magyarm/beaglebone-fpga/HardwareDesignFiles/documentation/bonefpga.csv

ref | value | footprint | Field1 | Field2 | Field3 | Field4 | Field5 | Field6 | Field7 | Field8
C201 | 10UF | 0805 | JMK212BJ106KD-T
C202 | 0.1UF | 0603 | C1608X5R1E104K
C203 | 1NF | 0603 | C1608X7R1H102K
C204 | 10PF | 0603 | C1608C0G1H100D
C205 | 1NF | 0603 | C1608X7R1H102K
C206 | 10PF | 0603 | C1608C0G1H100D
C207 | 100PF | 0603 | C1608X7R1H101K
C208 | 100PF | 0603 | C1608X7R1H101K
C209 | 4.7UF | 0603 | JMK107BJ475KA-T
C210 | 4.7UF | 0603 | JMK107BJ475KA-T
C211 | 4.7UF | 0603 | JMK107BJ475KA-T
C212 | 4.7UF | 0603 | JMK107BJ475KA-T
C213 | 10UF | 0805 | JMK212BJ106KD-T
C214 | 0.1UF | 0603 | C1608X5R1E104K
C215 | 1NF | 0603 | C1608X7R1H102K
C216 | 10PF | 0603 | C1608C0G1H100D
C217 | 1NF | 0603 | C1608X7R1H102K
C218 | 100PF | 0603 | C1608X7R1H101K
C219 | 10PF | 0603 | C1608C0G1H100D
C220 | 100PF | 0603 | C1608X7R1H101K
C221 | 4.7UF | 0603 | JMK107BJ475KA-T
C222 | 4.7UF | 0603 | JMK107BJ475KA-T
C223 | 4.7UF | 0603 | JMK107BJ475KA-T
C224 | 4.7UF | 0603 | JMK107BJ475KA-T
C301 | 10UF | 0603 | JMK212BJ106KD-T
C302 | 0.1UF | 0603 | C1608X5R1E104K
C401 | 0.1UF | 0603 | C1608X5R1E104K
C402 | 0.1UF | 0603 | C1608X5R1E104K
C701 | 0.47UF | 0603 | C1608X5R1A474K
C702 | 0.47UF | 0603 | C1608X5R1A474K
C703 | 0.47UF | 0603 | C1608X5R1A474K
C704 | 0.47UF | 0603 | C1608X5R1A474K
C705 | 0.47UF | 0603 | C1608X5R1A474K
C706 | 0.47UF | 0603 | C1608X5R1A474K
C707 | 0.47UF | 0603 | C1608X5R1A474K
C708 | 0.47UF | 0603 | C1608X5R1A474K
C709 | 0.47UF | 0603 | C1608X5R1A474K
C710 | 0.47UF | 0603 | C1608X5R1A474K
C711 | 0.47UF | 0603 | C1608X5R1A474K
C712 | 0.47UF | 0603 | C1608X5R1A474K
C713 | 4.7UF | 0603 | JMK107BJ475KA-T
C714 | 4.7UF | 0603 | JMK107BJ475KA-T
C715 | 4.7UF | 0603 | JMK107BJ475KA-T
C716 | 4.7UF | 0603 | JMK107BJ475KA-T
C717 | 4.7UF | 0603 | JMK107BJ475KA-T
C718 | 4.7UF | 0603 | JMK107BJ475KA-T
C719 | 100UF | 1206 | JMK316BJ107ML-T
C720 | 100UF | 1206 | JMK316BJ107ML-T
C721 | 100UF | 1206 | JMK316BJ107ML-T
C722 | 100UF | 1206 | JMK316BJ107ML-T
C723 | 100UF | 1206 | JMK316BJ107ML-T
C724 | 100UF | 1206 | JMK316BJ107ML-T
C725 | 0.1UF
C726 | 0.1UF
C727 | 0.1UF
C728 | 0.1UF
C729 | 0.1UF
C730 | 0.1UF
C731 | 4.7UF
C732 | 4.7UF
C733 | 4.7UF
C734 | 4.7UF
C735 | 4.7UF
C736 | 4.7UF
C737 | 100UF
C738 | 100UF
C739 | 100UF
C740 | 100UF
C741 | 100UF
C742 | 100UF
J701 | 3_WAY_JUMPER | 3 Pins, 2.54mm spacing, 1.02 hole diameter | TSHC-103-S-06-240-G-LF
J702 | 3_WAY_JUMPER | 3 Pins, 2.54mm spacing, 1.02 hole diameter | TSHC-103-S-06-240-G-LF
L201 | 2.2UH | 5.7x4.7 | NR6028T2R2N
L202 | 2.2UH | 5.7x4.7 | NR6028T2R2N
L203 | 2.2UH | 5.7x4.7 | NR6028T2R2N
L204 | 2.2UH | 5.7x4.7 | NR6028T2R2N
Q201 | 2N7002K | SOT-23-3 (TO-236) | 2N7002K-T1-E3
R201 | 10K | 0603 | ERJ-3GEYJ103V
R202 | 10K | 0603 | ERJ-3GEYJ103V
R203 | 0OHM | 0603 | DNI | ERJ-3EKF6042V
R204 | 0OHM | 0603 | ERJ-3EKF6042V
R205 | 150K | 0603 | ERJ-3GEYJ103V
R206 | 13K | 0603 | ERJ-3EKF1302V
R207 | 13K | 0603 | ERJ-3EKF1302V
R208 | 30K | 0603 | ERJ-3EKF3002V
R209 | 30K | 0603 | ERJ-3EKF3002V
R210 | 95.3K | 0603 | ERJ-3EKF9532V
R211 | 30K | 0603 | ERJ-3EKF3002V
R212 | 10K | 0603 | ERJ-3GEYJ103V
R213 | 10K | 0603 | ERJ-3GEYJ103V
R214 | 0OHM | 0603 | ERJ-3EKF6042V
R215 | 0OHM | 0603 | ERJ-3EKF6042V
R216 | 150K | 0603 | ERJ-3GEYJ103V
R217 | 95.3K | 0603 | ERJ-3EKF9532V
R218 | 13K | 0603 | ERJ-3EKF1302V
R219 | 100_OHM | 0603 | ERJ-3EKF1100V
R220 | 13K | 0603 | ERJ-3EKF1302V
R221 | 60_4K | 0603 | ERJ-3EKF6042V
R222 | 30K | 0603 | ERJ-3EKF3002V
R223 | 137K | 0603 | ERJ-3EKF1373V
R224 | 30K | 0603 | ERJ-3EKF3002V
R301 | 10K | 0603 | ERJ-3GEYJ103V
R302 | 10K | 0603 | ERJ-3GEYJ103V
R303 | 10K | 0603 | ERJ-3GEYJ103V
R304 | 10K | 0603 | ERJ-3GEYJ103V
R305 | 10K | 0603 | ERJ-3GEYJ103V
R306 | 10K | 0603 | ERJ-3GEYJ103V
R307 | 10K | 0603 | ERJ-3GEYJ103V
R308 | 100_OHM | 0603 | ERJ-3EKF1100V
R309 | 100_OHM | 0603 | ERJ-3EKF1100V
R310 | 100_OHM | 0603 | ERJ-3EKF1100V
R311 | 100_OHM | 0603 | ERJ-3EKF1100V
R401 | 330_OHM | 0603 | ERJ-3GEYJ331V
R402 | 4_7K | 0603 | ERJ-3GEYJ472V
R403 | 4_7K | 0603 | ERJ-3GEYJ472V
R404 | 4_7K | 0603 | ERJ-3GEYJ472V
R405 | 4_7K | 0603 | ERJ-3GEYJ472V
R406 | 4_7K | 0603 | ERJ-3GEYJ472V
R407 | 4_7K | 0603 | ERJ-3GEYJ472V
R408 | 4_7K | 0603 | ERJ-3GEYJ472V
R409 | 4_7K | 0603 | ERJ-3GEYJ472V
R410 | 4_7K | 0603 | ERJ-3GEYJ472V
U201 | DC_BARREL | 2 contacts, through hole, right angle, 6mm spacing | PJ-037A
U204 | LTC3546 | TSSOP-28 | LTC3546
U205 | BLUE_LED | 3.00mmx1.50mm | APL3015QBC/D-F01
U206 | LTC3546 | TSSOP-28 | LTC3546
U301 | SD_CARD_SLOT | SDcardFromBone | SCHA5B0200
U302 | FPGA_20_PIN_HEADER | 2x10 pins, 1.02mmx3.18mm pad, 2.54 mm spacing | SSHSM-110-D-02-H-V-LF
U303 | BLUE_LED | 3.00x1.50mm | APL3015QBC/D-F01
U304 | BLUE_LED | 3.00x1.50mm | APL3015QBC/D-F01
U305 | BLUE_LED | 3.00x1.50mm | APL3015QBC/D-F01
U306 | BLUE_LED | 3.00x1.50mm | APL3015QBC/D-F01
U401 | BEAGLEBONE
U404 | XRA1207 | TSSOP-24 | XRA1207IG24-F
U405 | 100MHZOSC | 1.4x1.2mm, 5.08x3.7mm spacing | CB3LV-3I-100M0000
U406 | EEPROM_SWITCH | 6.2x6.02mm, pads: 3x1.1mm | A6S-2102-H
U407 | CAT24C256 | TSSOP-8 | CAT24C256YI-GT3
U501 | FPGA_20_PIN_HEADER | 2x10 pins, 1.02mmx3.18mm pad, 2.54 mm spacing | SSHSM-110-D-02-H-V-LF
U601 | FPGA_20_PIN_HEADER | 2x10 pins, 1.02mmx3.18mm pad, 2.54 mm spacing | SSHSM-110-D-02-H-V-LF
U701 | JTAG_CONN | 6 Pins, 2.54mm spacing, 1.02 hole diameter | 6 Pins, 2.54mm spacing, 1.02 hole diameter
U702 | XC6SLX25FTG256 | 256 BGA | XC6SLX25FTG256
