magyarm/beaglebone-fpga/bonefpga.ods

Sheet: BOM_list
ref | Value | Footprint | Manufacturer | Part Number
C201 | 10UF |  | Taiyo Yuden | LMK212BJ106KG-T
C202 | 2_2NF |  | AVX | 08053A222JAT2A
C203 | 10UF |  | Taiyo Yuden | LMK212BJ106KG-T
C204 | 2_2NF |  | AVX | 08053A222JAT2A
C205 | 22UF |  | TDK | C2012X5R0J226M
C206 | 100NF |  | Kemet | C0805C104K3RACTU
C207 | 10UF |  | Taiyo Yuden | LMK212BJ106KG-T
C208 | 2_2NF |  | AVX | 08053A222JAT2A
C209 | 220NF |  | Kemet | C0805C224K5RACTU
C401 | 0.1UF | 603 |  | C1608X5R1E104K
C701 | 0.47UF | 603 |  | C1608X5R1A474K
C702 | 0.47UF | 604 |  | C1608X5R1A474K
C703 | 0.47UF | 605 |  | C1608X5R1A474K
C704 | 0.47UF | 606 |  | C1608X5R1A474K
C705 | 0.47UF | 607 |  | C1608X5R1A474K
C706 | 0.47UF | 608 |  | C1608X5R1A474K
C707 | 0.47UF | 609 |  | C1608X5R1A474K
C708 | 0.47UF | 610 |  | C1608X5R1A474K
C709 | 4.7UF | 603 |  | JMK107BJ475KA-T
C710 | 0.47UF | 610 |  | C1608X5R1A474K
C711 | 0.47UF | 610 |  | C1608X5R1A474K
C712 | 0.47UF | 610 |  | C1608X5R1A474K
C713 | 4.7UF | 603 |  | JMK107BJ475KA-T
C714 | 4.7UF | 603 |  | JMK107BJ475KA-T
C715 | 0.47UF | 610 |  | C1608X5R1A474K
C716 | 4.7UF | 603 |  | JMK107BJ475KA-T
C717 | 4.7UF | 603 |  | JMK107BJ475KA-T
C718 | 4.7UF | 603 |  | JMK107BJ475KA-T
C719 | 100UF | 1206 |  | JMK316BJ107ML-T
C720 | 100UF | 1206 |  | JMK316BJ107ML-T
C721 | 100UF | 1206 |  | JMK316BJ107ML-T
C722 | 100UF | 1206 |  | JMK316BJ107ML-T
C723 | 100UF | 1206 |  | JMK316BJ107ML-T
C724 | 100UF | 1206 |  | JMK316BJ107ML-T
L201 | 2.2UH |  | TDK | VLC6045T-2R2N
L202 | 100NH |  | TDK | NLCV32T-R10M-PFR
L203 | 2.2UH |  | TDK | VLC6045T-2R2N
L204 | 100NH |  | TDK | NLCV32T-R10M-PFR
L205 | 2.2UH |  | TDK | VLC6045T-2R2N
R201 | 100K |  | Panasonic | ERJ-3GEYJ104V
R202 | 100K |  | Panasonic | ERJ-3GEYJ104V
R203 | 10K |  | Panasonic | ERJ-3GEYJ103V
R204 | 20K |  | Panasonic | ERJ-3EKF2002V
R205 | 100K |  | Panasonic | ERJ-3GEYJ104V
R206 | 62K |  | Panasonic | ERJ-3EKF6202V
R207 | 20K |  | Panasonic | ERJ-3EKF2002V
R308 | 100_OHM | 603 |  | ERJ-3EKF1100V
R310 | 100_OHM | 603 |  | ERJ-3EKF1100V
R401 | 330_OHM | 603 |  | ERJ-3GEYJ331V
R402 | 4_7K | 603 |  | ERJ-3GEYJ472V
R403 | 4_7K | 603 |  | ERJ-3GEYJ472V
R404 | 60_4K | 603 |  | ERJ-3EKF6042V
R405 | 4_7K | 603 |  | ERJ-3GEYJ472V
R406 | 4_7K | 603 |  | ERJ-3GEYJ472V
R407 | 4_7K | 603 |  | ERJ-3GEYJ472V
R408 | 10K | 603 |  | ERJ-3GEYJ103V
R409 | 10K | 603 |  | ERJ-3GEYJ103V
R410 | 10K | 603 |  | ERJ-3GEYJ103V
U201 | DC_BARREL |  |  | PJ-037A
U202 | TPS62132 |  |  | TPS62132RG
U203 | TPS62130 |  |  | TPS62130RGT
U204 | TPS62130 |  |  | TPS62130RGT
U205 | JTAG_CONN |  |  | DNI
U303 | BLUE_LED |  |  | APL3015QBC/D-F01
U305 | BLUE_LED |  |  | APL3015QBC/D-F01
U401 | BEAGLEBONE |  |  | DNI
U404 | XRA1207 |  |  | XRA1207IG24-F
U405 | 100MHZOSC |  |  | CB3LV-3I-100M0000
U406 | EEPROM_SWITCH |  |  | A6S-2102-H
U407 | CAT24C256 |  |  | CAT24C256YI-GT3
U501 | FPGA_20_PIN_HEADER |  |  | BCS-110-L-D-TE
U503 | W9825G6JH |  |  | W9825G6JH-6I
U601 | FPGA_20_PIN_HEADER |  |  | BCS-110-L-D-TE
U701 | JTAG_CONN |  |  | DNI
U702 | XC6SLX25FTG256 |  |  | XC6SLX25-2FTG256C

Sheet: BOM_Itemized
Reference Designator | Value | Part Number | Supplier | Quantity Required | $ per 1 |  | $ per 500
C201, C203, C207 | 10UF | LMK212BJ106KG-T | Digikey | 3 | 0.2 | 0.6 | 0.0469 | 0.1407
C202, C204, C208 | 2_2NF | 08053A222JAT2A | Digikey | 2 | 0.25 | 0.5 | 0.0621 | 0.1242
C205 | 22UF | C2012X5R0J226M | Digikey | 1 | 0.29 | 0.29 | 0.0795 | 0.0795
C206 | 100NF | C0805C104K3RACTU | Digikey | 1 | 0.1 | 0.1 | 0.01578 | 0.01578
C209 | 220NF | C0805C224K5RACTU | Digikey | 1 | 0.14 | 0.14 | 0.03182 | 0.03182
C401 | 0.1UF | C1608X5R1E104K | Digikey | 1 | 0.1 | 0.1 | 0.0077 | 0.0077
C701, C702, C703, C704, C705, C706, C707, C708, C710, C711, C712, C715 | 0.47UF | C1608X5R1A474K | Digikey | 12 | 0.1 | 1.2 | 0.01926 | 0.23112
C709, C713, C714, C716, C717, C718 | 4.7UF | JMK107BJ475KA-T | Digikey | 6 | 0.13 | 0.78 | 0.03016 | 0.18096
C719, C720, C721, C722, C723, C724 | 100UF | JMK316BJ107ML-T | Digikey | 6 | 1.18 | 7.08 | 0.4725 | 2.835
L201, L203, L205 | 2.2UH | VLC6045T-2R2N | Digikey | 3 | 0.52 | 1.56 | 0.299 | 0.897
L202, L204 | 100NH | NLCV32T-R10M-PFR | Digikey | 2 | 0.28 | 0.56 | 0.15676 | 0.31352
R201, R202, R205 | 100K | ERJ-3GEYJ104V | Digikey | 3 | 0.1 | 0.3 | 0.00384 | 0.01152
R203, R408, R409, R410 | 10K | ERJ-3GEYJ103V | Digikey | 4 | 0.1 | 0.4 | 0.00384 | 0.01536
R204, R207 | 20K | ERJ-3EKF2002V | Digikey | 2 | 0.1 | 0.2 | 0.00384 | 0.00768
R206 | 62K | ERJ-3EKF6202V | Digikey | 1 | 0.1 | 0.1 | 0.00576 | 0.00576
R308, R310 | 100_OHM | ERJ-3EKF1100V | Digikey | 2 | 0.1 | 0.2 | 0.00576 | 0.01152
R401 | 330_OHM | ERJ-3GEYJ331V | Digikey | 1 | 0.1 | 0.1 | 0.00384 | 0.00384
R402, R403, R405, R406, R407 | 4_7K | ERJ-3GEYJ472V | Digikey | 5 | 0.1 | 0.5 | 0.00384 | 0.0192
R404 | 60_4K | ERJ-3EKF6042V | Digikey | 1 | 0.1 | 0.1 | 0.00576 | 0.00576
U201 | DC_BARREL | PJ-037A | Digikey | 1 | 1.05 | 1.05 | 0.399 | 0.399
U202 | TPS62132 | TPS62132RG | Mouser | 1 | 3.62 | 3.62 | 1.92 | 1.92
U203, U204 | TPS62130 | TPS62130RGT | Mouser | 2 | 3.62 | 7.24 | 1.92 | 3.84
U205, U701 | JTAG_CONN | DNI | N/A | 0 | 0 | 0 | 0 | 0
U303, U305 | BLUE_LED | APL3015QBC/D-F01 | Digikey | 2 | 0.43 | 0.86 | 0.1872 | 0.3744
U401 | BEAGLEBONE | DNI | N/A | 0 | 0 | 0 | 0 | 0
U404 | XRA1207 | XRA1207IG24-F | Digikey | 1 | 2.71 | 2.71 | 1.5309 | 1.5309
U405 | 100MHZOSC | CB3LV-3I-100M0000 | Digikey | 1 | 2.41 | 2.41 | 1.90816 | 1.90816
U406 | EEPROM_SWITCH | A6S-2102-H | Digikey | 1 | 1.51 | 1.51 | 1.0449 | 1.0449
U407 | CAT24C256 | CAT24C256YI-GT3 | Digikey | 1 | 0.71 | 0.71 | 0.35536 | 0.35536
U501, U601 | FPGA_20_PIN_HEADER | BCS-110-L-D-TE | Digikey | 2 | 4.36 | 8.72 | 2.5395 | 5.079
U503 | W9825G6JH | W9825G6JH-6I | Digikey | 1 | 2.97 | 2.97 | 2.25882 | 2.25882
U702 | XC6SLX25FTG256 | XC6SLX25-2FTG256C | AvNet | 1 | 32.19 | 32.19 | 32.19 | 32.19
 |  |  |  |  | Totals: | 78.8 |  | 55.83848

Sheet: manufacturers
Name | Email | Date Sent | Quote | Turn Around Time | Notes
Microart | sales@microart.ca | 2012/09/11 |  |  | Contact name Mark. Kean knows these guys.
Zhong Xin Hua Group | wmb05@zxhgroup.com | 2012/09/14 |  |  | IM'd with ViVi Chen.
Shenzhen Great Electronics | Contacted via alibaba | 2012/09/14 |  |  | Contact name Alice Lee.\
Lian Da Jin Electronic Limited | Contacted via alibaba | 2012/09/14 |  |  | Contact name Milicent Tan
Advanced Circuits | forrest@4pcb.com | 2012/09/15 |  |  | Contact: Forrest Arndt
CCI Canadian Circuits | sales@canadiancircuits.com | 2012/09/15
CircuitCo | sales@circuitco.com | 2012/09/16

Sheet: GPMC
Signal Name |  | Connection(Pin) |  | Length
Bone | Me | Bone | FPGA | Bone (mils) | Bone (mm) | Me (mm) | Should be (mm) | Sum | Difference (Squiggle) | Target
GPIO1_0 | GPMC_AD0 | P8-25 | B2 | 460.33 | 11.692382 | 39.796 | 39.307618 | 51.488382 | -0.488382 | 51
GPIO1_1 | GPMC_AD1 | P8-24 | C1 | 554.1 | 14.07414 | 38.291 | 36.92586 | 52.36514 | -1.36514 | 51
GPIO1_2 | GPMC_AD2 | P8-5 | P2 | 1260.22 | 32.009588 | 18.306 | 18.990412 | 50.315588 | 0.684412 | 51
GPIO1_3 | GPMC_AD3 | P8-6 | P1 | 1317.01 | 33.452054 | 19.848 | 17.547946 | 53.300054 | -2.300054 | 51
GPIO1_4 | GPMC_AD4 | P8-23 | C2 | 452.48 | 11.492992 | 36.215 | 39.507008 | 47.707992 | 3.292008 | 51
GPIO1_5 | GPMC_AD5 | P8-22 | D1 | 549.33 | 13.952982 | 36.939 | 37.047018 | 50.891982 | 0.108018 | 51
GPIO1_6 | GPMC_AD6 | P8-3 | R2 | 1329.6 | 33.77184 | 19.855 | 17.22816 | 53.62684 | -2.62684 | 51
GPIO1_7 | GPMC_AD7 | P8-4 | R1 | 1395.18 | 35.437572 | 20.495 | 15.562428 | 55.932572 | -4.932572 | 51
EHRPWM2A | GPMC_AD8 | P8-19 | E2 | 1166.49 | 29.628846 | 23.34 | 21.371154 | 52.968846 | -1.968846 | 51
EHRPWM2B | GPMC_AD9 | P8-13 | J1 | 1124.85 | 28.57119 | 18.148 | 22.42881 | 46.71919 | 4.28081 | 51
GPIO0_26 | GPMC_AD10 | P8-14 | H2 | 1148.21 | 29.164534 | 19.169 | 21.835466 | 48.333534 | 2.666466 | 51
GPIO0_27 | GPMC_AD11 | P8-17 | F2 | 1159.78 | 29.458412 | 18.56 | 21.541588 | 48.018412 | 2.981588 | 51
GPIO1_12 | GPMC_AD12 | P8-12 | K1 | 1139.2 | 28.93568 | 18.346 | 22.06432 | 47.28168 | 3.71832 | 51
GPIO1_13 | GPMC_AD13 | P8-11 | K2 | 1135.4 | 28.83916 | 20.47 | 22.16084 | 49.30916 | 1.69084 | 51
GPIO1_14 | GPMC_AD14 | P8-16 | G1 | 1160.34 | 29.472636 | 17.635 | 21.527364 | 47.107636 | 3.892364 | 51
GPIO1_15 | GPMC_AD15 | P8-15 | H1 | 1166.9 | 29.63926 | 21.433 | 21.36074 | 51.07226 | -0.07226 | 51
GPIO2_1 | GPMC_CLK | P8-18 | F1 | 706.36 | 17.941544 | 30.9 | 33.058456 | 48.841544 | 2.158456 | 51
TIMER4 | GPMC_ADVN_ALE | P8-7 | N1 | 1190.84 | 30.247336 |  | -30.247336 | 30.247336 | -30.247336
TIMER5 | GPMC_BEON_CLE | P8-9 | M1 | 1090.85 | 27.70759 |  | -27.70759 | 27.70759 | -27.70759
TIMER7 | GPMC_OEN | P8-8 | M2 | 1247.64 | 31.690056 |  | -31.690056 | 31.690056 | -31.690056
TIMER6 | GPMC_WEN | P8-10 | L1 | 1190.67 | 30.243018 |  | -30.243018 | 30.243018 | -30.243018
GPIO1_29 | GPMC_CSN0 | P8-26 | B1 | 539.17 | 13.694918 |  | -13.694918 | 13.694918 | -13.694918
GPIO1_30 | GPMC_CSN1 | P8-21 | D3 | 480.82 | 12.212828 |  | -12.212828 | 12.212828 | -12.212828
GPIO1_31 | GPMC_CSN2 | P8-20 | E1 | 612.86 | 15.566644 |  | -15.566644 | 15.566644 | -15.566644
GPIO1_28 | GPMC_BE1N | P9-12 | P12 | 1827.2 | 46.41088 |  | -46.41088 | 46.41088 | -46.41088

Sheet: GPIOBank_Mapping
Bank Pin | FPGA Pin
0_1 | A4
0_2 | C4
0_3 | A5
0_4 | B5
0_5 | A6
0_6 | B6
0_7 | A7
0_8 | C7
0_9 | A8
0_10 | B8
0_11 | A9
0_12 | C9
0_13 | A10
0_14 | B10
0_15 | A12
0_16 | B12
0_17 | A13
0_18 | C13
0_19 | A14
0_20 | B14
1_1 | B16
1_2 | B15
1_3 | C16
1_4 | C15
1_5 | D16
1_6 | D14
1_7 | E16
1_8 | E15
1_9 | F16
1_10 | F15
1_11 | G16
1_12 | G14
1_13 | H16
1_14 | H15
1_15 | J16
1_16 | J14
1_17 | K16
1_18 | K15
1_19 | L16
1_20 | L14

Sheet: SDRAM Pins
SDRAM Connections |  | FPGA Pin
Pin | Function
2 | DQ0 | R14
4 | DQ1 | M13
5 | DQ2 | L13
7 | DQ3 | K12
8 | DQ4 | G16
10 | DQ5 | G14
11 | DQ6 | H16
13 | DQ7 | H15
15 | LDQM | H14
16 | WE| | J16
17 | CAS| | K16
18 | RAS| | L16
19 | CS| | K15
20 | BS0 | J14
21 | BS1 | K14
22 | A10/AP | D16
23 | A0 | F13
24 | A1 | F12
25 | A2 | E13
26 | A3 | E12
29 | A4 | B15
30 | A5 | B16
31 | A6 | C15
32 | A7 | C16
33 | A8 | D14
34 | A9 | L14
35 | A11 | E15
36 | A12 | E16
37 | CKE | F14
38 | CLK | F15
39 | UDMQ | F16
42 | DQ8 | M16
44 | DQ9 | M15
45 | DQ10 | T14
47 | DQ11 | J13
48 | DQ12 | P16
50 | DQ13 | P15
51 | DQ14 | R16
53 | DQ15
