magyarm/beaglebone-fpga/HardwareDesignFiles/schematics/$file4FE6399C.sch

## KiCad design HardwareDesignFiles/schematics/$file4FE6399C.sch (2012-11-10)

Schematic: $file4FE6399C.sch

Parts:
C201, C203, C207: 10UF; Part Number LMK212BJ106KG-T
C202, C204, C208: 2_2NF; Part Number 08053A222JAT2A
C205: 22UF; Part Number C2012X5R0J226M
C206: 100NF; Part Number C0805C104K3RACTU
C209: 220NF; Part Number C0805C224K5RACTU
L201, L203, L205: 2.2UH; Part Number VLC6045T-2R2N
L202, L204: 100NH; Part Number NLCV32T-R10M-PFR
R201, R202, R205: 100K; Part Number ERJ-3GEYJ104V
R203: 10K; Part Number ERJ-3GEYJ103V
R204, R207: 20K; Part Number ERJ-3EKF2002V
R206: 62K; Part Number ERJ-3EKF6202V
U201: DC_BARREL
U202: TPS62132
U203, U204: TPS62130
U205: JTAG_CONN
