magyarm/beaglebone-fpga/HardwareDesignFiles/schematics/file4FE276D0.sch

## KiCad design HardwareDesignFiles/schematics/file4FE276D0.sch (2012-12-31)

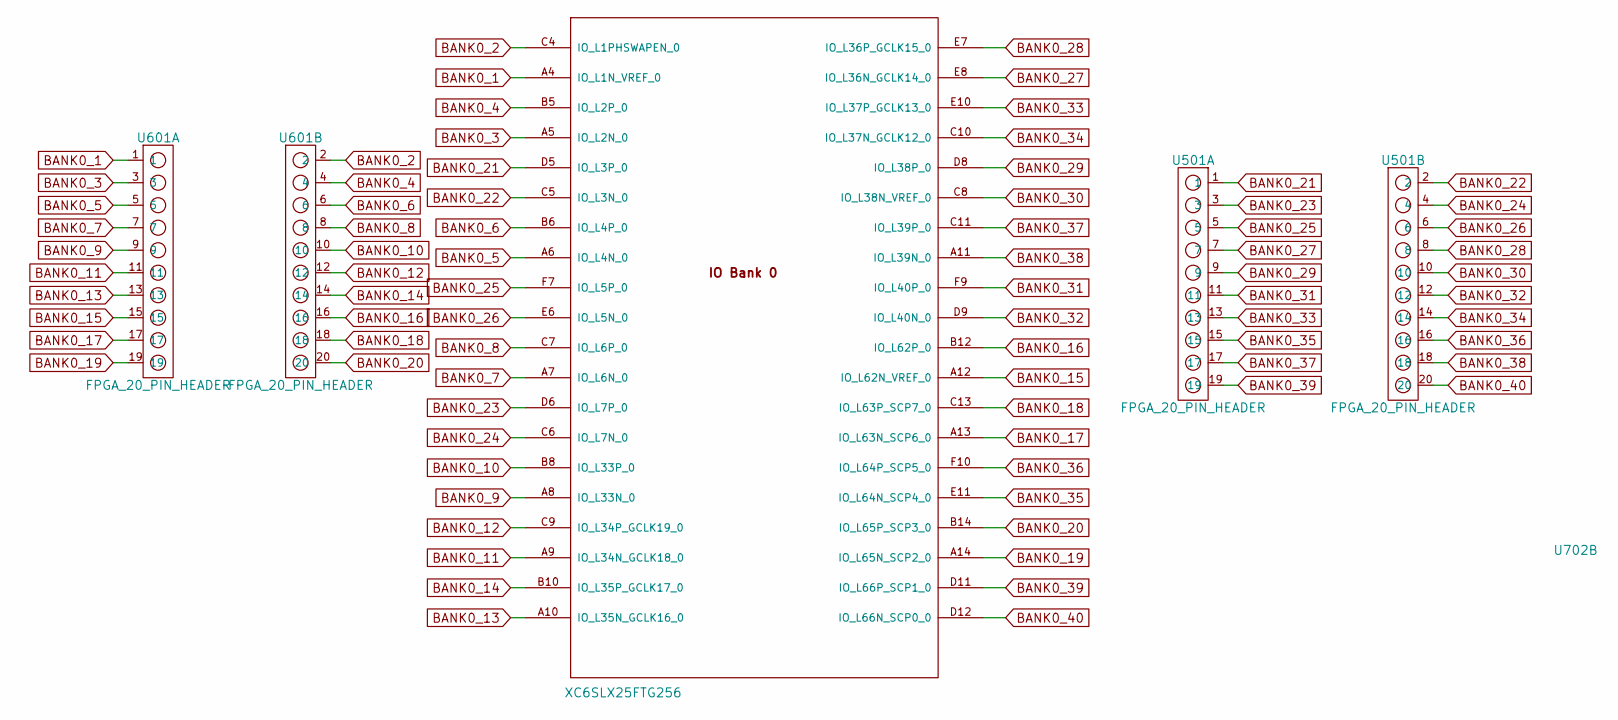
[picture p1: schematic file4FE276D0.sch]

Parts:
U501, U601: FPGA_20_PIN_HEADER
U702: XC6SLX25FTG256

Connections:
BANK0_1: U601.1, U702.A4 (IO_L1N_VREF_0)
BANK0_2: U601.2, U702.C4 (IO_L1PHSWAPEN_0)
BANK0_3: U601.3, U702.A5 (IO_L2N_0)
BANK0_4: U601.4, U702.B5 (IO_L2P_0)
BANK0_5: U601.5, U702.A6 (IO_L4N_0)
BANK0_6: U601.6, U702.B6 (IO_L4P_0)
BANK0_7: U601.7, U702.A7 (IO_L6N_0)
BANK0_8: U601.8, U702.C7 (IO_L6P_0)
BANK0_9: U601.9, U702.A8 (IO_L33N_0)
BANK0_10: U601.10, U702.B8 (IO_L33P_0)
BANK0_11: U601.11, U702.A9 (IO_L34N_GCLK18_0)
BANK0_12: U601.12, U702.C9 (IO_L34P_GCLK19_0)
BANK0_13: U601.13, U702.A10 (IO_L35N_GCLK16_0)
BANK0_14: U601.14, U702.B10 (IO_L35P_GCLK17_0)
BANK0_15: U601.15, U702.A12 (IO_L62N_VREF_0)
BANK0_16: U601.16, U702.B12 (IO_L62P_0)
BANK0_17: U601.17, U702.A13 (IO_L63N_SCP6_0)
BANK0_18: U601.18, U702.C13 (IO_L63P_SCP7_0)
BANK0_19: U601.19, U702.A14 (IO_L65N_SCP2_0)
BANK0_20: U601.20, U702.B14 (IO_L65P_SCP3_0)
BANK0_21: U501.1, U702.D5 (IO_L3P_0)
BANK0_22: U501.2, U702.C5 (IO_L3N_0)
BANK0_23: U501.3, U702.D6 (IO_L7P_0)
BANK0_24: U501.4, U702.C6 (IO_L7N_0)
BANK0_25: U501.5, U702.F7 (IO_L5P_0)
BANK0_26: U501.6, U702.E6 (IO_L5N_0)
BANK0_27: U501.7, U702.E8 (IO_L36N_GCLK14_0)
BANK0_28: U501.8, U702.E7 (IO_L36P_GCLK15_0)
BANK0_29: U501.9, U702.D8 (IO_L38P_0)
BANK0_30: U501.10, U702.C8 (IO_L38N_VREF_0)
BANK0_31: U501.11, U702.F9 (IO_L40P_0)
BANK0_32: U501.12, U702.D9 (IO_L40N_0)
BANK0_33: U501.13, U702.E10 (IO_L37P_GCLK13_0)
BANK0_34: U501.14, U702.C10 (IO_L37N_GCLK12_0)
BANK0_35: U501.15, U702.E11 (IO_L64N_SCP4_0)
BANK0_36: U501.16, U702.F10 (IO_L64P_SCP5_0)
BANK0_37: U501.17, U702.C11 (IO_L39P_0)
BANK0_38: U501.18, U702.A11 (IO_L39N_0)
BANK0_39: U501.19, U702.D11 (IO_L66P_SCP1_0)
BANK0_40: U501.20, U702.D12 (IO_L66N_SCP0_0)
