magyarm/beaglebone-fpga/HardwareDesignFiles/schematics/file4FE276F3.sch

## KiCad design HardwareDesignFiles/schematics/file4FE276F3.sch (2012-12-31)

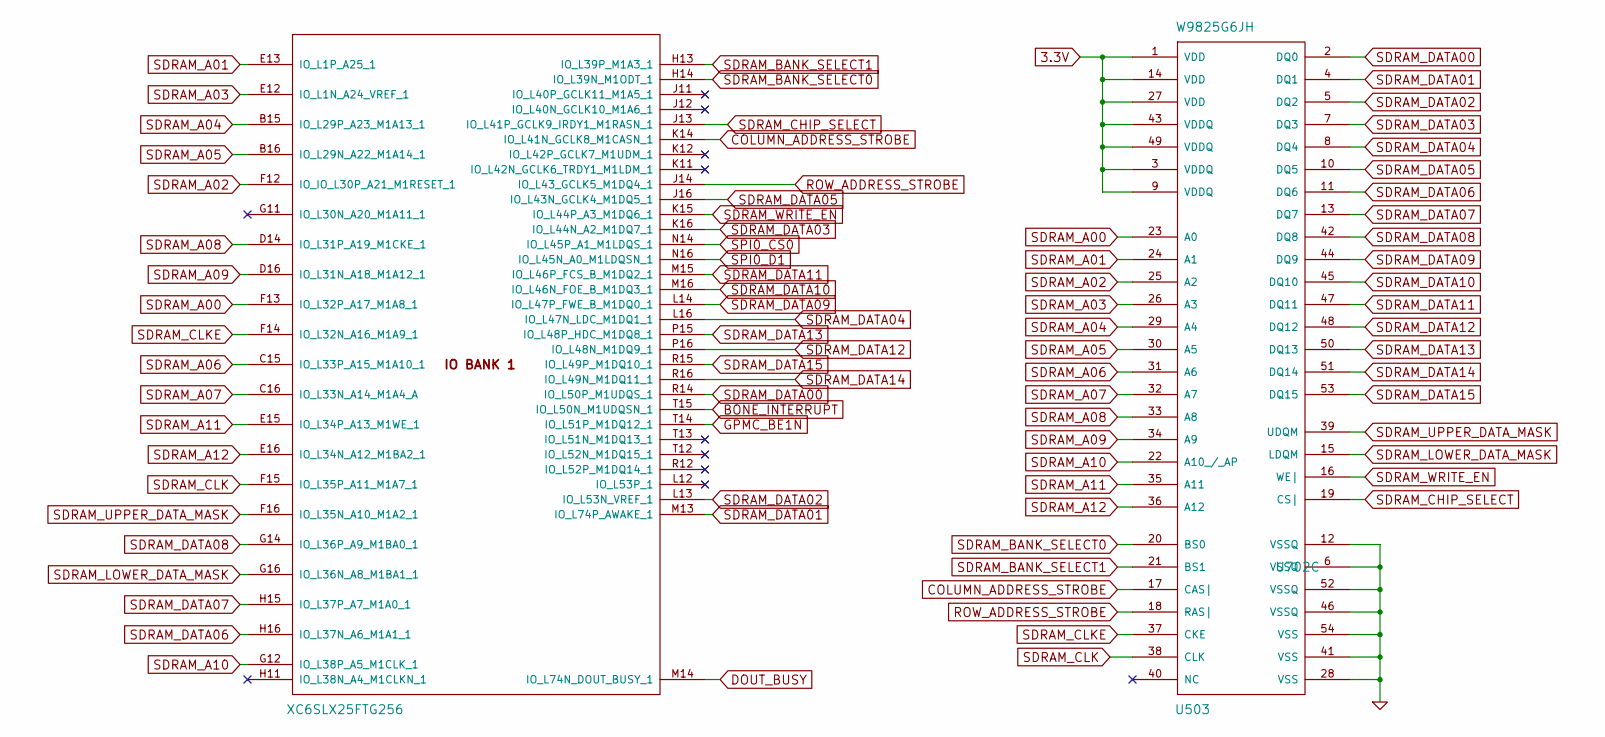
[picture p2: schematic file4FE276F3.sch]

Parts:
U503: W9825G6JH
U702: XC6SLX25FTG256

Connections:
3.3V: U503.1 (VDD), U503.3 (VDDQ), U503.9 (VDDQ), U503.14 (VDD), U503.27 (VDD), U503.43 (VDDQ), U503.49 (VDDQ)
BONE_INTERRUPT: U702.T15 (IO_L50N_M1UDQSN_1)
COLUMN_ADDRESS_STROBE: U503.17 (CAS|), U702.K14 (IO_L41N_GCLK8_M1CASN_1)
DOUT_BUSY: U702.M14 (IO_L74N_DOUT_BUSY_1)
GND: U503.6 (VSSQ), U503.12 (VSSQ), U503.28 (VSS), U503.41 (VSS), U503.46 (VSSQ), U503.52 (VSSQ), U503.54 (VSS)
GPMC_BE1N: U702.T14 (IO_L51P_M1DQ12_1)
ROW_ADDRESS_STROBE: U503.18 (RAS|), U702.J14 (IO_L43_GCLK5_M1DQ4_1)
SDRAM_A00: U503.23 (A0), U702.F13 (IO_L32P_A17_M1A8_1)
SDRAM_A01: U503.24 (A1), U702.E13 (IO_L1P_A25_1)
SDRAM_A02: U503.25 (A2), U702.F12 (IO_IO_L30P_A21_M1RESET_1)
SDRAM_A03: U503.26 (A3), U702.E12 (IO_L1N_A24_VREF_1)
SDRAM_A04: U503.29 (A4), U702.B15 (IO_L29P_A23_M1A13_1)
SDRAM_A05: U503.30 (A5), U702.B16 (IO_L29N_A22_M1A14_1)
SDRAM_A06: U503.31 (A6), U702.C15 (IO_L33P_A15_M1A10_1)
SDRAM_A07: U503.32 (A7), U702.C16 (IO_L33N_A14_M1A4_A)
SDRAM_A08: U503.33 (A8), U702.D14 (IO_L31P_A19_M1CKE_1)
SDRAM_A09: U503.34 (A9), U702.D16 (IO_L31N_A18_M1A12_1)
SDRAM_A10: U503.22 (A10_/_AP), U702.G12 (IO_L38P_A5_M1CLK_1)
SDRAM_A11: U503.35 (A11), U702.E15 (IO_L34P_A13_M1WE_1)
SDRAM_A12: U503.36 (A12), U702.E16 (IO_L34N_A12_M1BA2_1)
SDRAM_BANK_SELECT0: U503.20 (BS0), U702.H14 (IO_L39N_M1ODT_1)
SDRAM_BANK_SELECT1: U503.21 (BS1), U702.H13 (IO_L39P_M1A3_1)
SDRAM_CHIP_SELECT: U503.19 (CS|), U702.J13 (IO_L41P_GCLK9_IRDY1_M1RASN_1)
SDRAM_CLK: U503.38 (CLK), U702.F15 (IO_L35P_A11_M1A7_1)
SDRAM_CLKE: U503.37 (CKE), U702.F14 (IO_L32N_A16_M1A9_1)
SDRAM_DATA00: U503.2 (DQ0), U702.R14 (IO_L50P_M1UDQS_1)
SDRAM_DATA01: U503.4 (DQ1), U702.M13 (IO_L74P_AWAKE_1)
SDRAM_DATA02: U503.5 (DQ2), U702.L13 (IO_L53N_VREF_1)
SDRAM_DATA03: U503.7 (DQ3), U702.K16 (IO_L44N_A2_M1DQ7_1)
SDRAM_DATA04: U503.8 (DQ4), U702.L16 (IO_L47N_LDC_M1DQ1_1)
SDRAM_DATA05: U503.10 (DQ5), U702.J16 (IO_L43N_GCLK4_M1DQ5_1)
SDRAM_DATA06: U503.11 (DQ6), U702.H16 (IO_L37N_A6_M1A1_1)
SDRAM_DATA07: U503.13 (DQ7), U702.H15 (IO_L37P_A7_M1A0_1)
SDRAM_DATA08: U503.42 (DQ8), U702.G14 (IO_L36P_A9_M1BA0_1)
SDRAM_DATA09: U503.44 (DQ9), U702.L14 (IO_L47P_FWE_B_M1DQ0_1)
SDRAM_DATA10: U503.45 (DQ10), U702.M16 (IO_L46N_FOE_B_M1DQ3_1)
SDRAM_DATA11: U503.47 (DQ11), U702.M15 (IO_L46P_FCS_B_M1DQ2_1)
SDRAM_DATA12: U503.48 (DQ12), U702.P16 (IO_L48N_M1DQ9_1)
SDRAM_DATA13: U503.50 (DQ13), U702.P15 (IO_L48P_HDC_M1DQ8_1)
SDRAM_DATA14: U503.51 (DQ14), U702.R16 (IO_L49N_M1DQ11_1)
SDRAM_DATA15: U503.53 (DQ15), U702.R15 (IO_L49P_M1DQ10_1)
SDRAM_LOWER_DATA_MASK: U503.15 (LDQM), U702.G16 (IO_L36N_A8_M1BA1_1)
SDRAM_UPPER_DATA_MASK: U503.39 (UDQM), U702.F16 (IO_L35N_A10_M1A2_1)
SDRAM_WRITE_EN: U503.16 (WE|), U702.K15 (IO_L44P_A3_M1DQ6_1)
SPI0_CS0: U702.N14 (IO_L45P_A1_M1LDQS_1)
SPI0_D1: U702.N16 (IO_L45N_A0_M1LDQSN_1)
