magyarm/beaglebone-fpga/HardwareDesignFiles/schematics/file4FE2765D.sch

## KiCad design HardwareDesignFiles/schematics/file4FE2765D.sch (2012-12-31)

Schematic: file4FE2765D.sch

Parts:
C701, C702, C703, C704, C705, C706, C707, C708, C710, C711, C712, C715: 0.47UF
C709, C713, C714, C716, C717, C718: 4.7UF
C719, C720, C721, C722, C723, C724: 100UF
U701: JTAG_CONN
U702: XC6SLX25FTG256
