magyarm/beaglebone-fpga/HardwareDesignFiles/schematics/file4FE27748.sch

## KiCad design HardwareDesignFiles/schematics/file4FE27748.sch (2012-12-31)

Schematic: file4FE27748.sch

Parts:
C401: 0.1UF
R308, R310: 100_OHM
R401: 330_OHM
R402, R403, R405, R406, R407: 4_7K
R404: 60_4K
R408, R409, R410: 10K
U303, U305: BLUE_LED
U401: BEAGLEBONE
U404: XRA1207
U405: 100MHZOSC
U406: EEPROM_SWITCH
U407: CAT24C256
U702: XC6SLX25FTG256

Notes on the sheet:
This whole mess is to simplify the routing. The nets cross a lot on the schematic, but this actually minimizes the trace crossing
