magyarm/beaglebone-fpga/(commit log)

2012-08-29 First commit of Michael Magyar's Beaglebone-FPGA Project. I have been really poor at revision control so far, so hopefully this first commit will change that.
    [bonefpga.brd, bonefpga.csv, bonefpga.dsn, bonefpga.sch, bonefpga_try1.brd, bonefpga_try3.brd]
2012-09-10 Updated Hardeware Design files. Greatly improved file/folder structure. Remaining PCB layout errors corrected. Gerbers and Drill files created. The schematics are still not up to date since I lost th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
    [bonefpga-Back.gbl, bonefpga-Front.gtl, bonefpga-Inner2.gbr, bonefpga-Inner3.gbr, bonefpga-Inner4.gbr, bonefpga-Inner5.gbr, bonefpga-PCB_Edges.gbr, bonefpga-SilkS_Back.gbo]
2012-09-10 Old messy file/directory structure. No longer needed with the new HardwareDesign folder and structure.
    [bonefpga.brd, bonefpga.csv, bonefpga.dsn, bonefpga.sch, bonefpga_try1.brd, bonefpga_try3.brd]
2012-09-11 Updated Schematics for GPMC connections. Moved GPMC from Bank 2 to Bank 3. Schematics now agree with the netlist and pcb design for gpmc connections. This is now inline with before the data loss. FPG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
    [bonefpga.sch, file4FE2765D.sch, file4FE276D0.sch, file4FE276F3.sch, file4FE27748.sch, file4FE27756.sch, file4FE6399C.sch]
2012-09-12 Fixed Oscillatory connection to fpga
    [bonefpga.sch, file4FE2765D.sch, file4FE276D0.sch, file4FE276F3.sch, file4FE27748.sch, file4FE27756.sch, file4FE6399C.sch]
2012-09-12 Moved the drill files to a drill folder. Shouldn't have been in the Gerber directory anyway.
    [bonefpga-PCB_Edges.gbr, bonefpga-SilkS_Back.gbo, bonefpga-copper-inner1.drl, bonefpga-inner1-inner2.drl, bonefpga-inner2-inner3.drl, bonefpga-inner3-inner4.drl, bonefpga-inner4-cmp.drl, bonefpga.drl]
2012-09-12 Regenerated Gerbers. Not much changed. Was just paying around with file formats and outputs. This is now correct I think.
    [bonefpga-Back.gbl, bonefpga-Front.gtl, bonefpga-Inner2.gbr, bonefpga-Inner3.gbr, bonefpga-Inner4.gbr, bonefpga-Inner5.gbr, bonefpga-SilkS_Front.gto]
2012-09-12 Slight change to a track position
    [bonefpga.brd]
2012-09-12 The spreadsheet with working values. GPMC lengths, and BOM lists.
    [bonefpga.ods]
2012-09-19 Updated BOM list in spreadsheet
    [bonefpga.ods]
2012-09-25 Corrected Bank_0 connections, and other miscillaneous fixes.
    [bonefpga-Mask_Back.gbs, bonefpga-Mask_Front.gts, bonefpga-SilkS_Back.gbo, bonefpga-SilkS_Front.gto, bonefpga-copper-inner1.drl, bonefpga-inner1-inner2.drl, bonefpga-inner2-inner3.drl, bonefpga-inner3-inner4.drl]
2012-09-25 Updated README with current project status.
2012-09-25 Updated FPGA Bank 1 connections and IO-Expander to FPGA configuration connections.
    [bonefpga.sch, file4FE2765D.sch, file4FE276D0.sch, file4FE276F3.sch, file4FE27748.sch, file4FE27756.sch, file4FE6399C.sch]
2012-09-27 Before making change: Changing far fpga header to bank 0, not bank 1. Bank 1 is to now be allocated for external RAM (in a future spin).
    [bonefpga.brd, bonefpga.sch, file4FE2765D.sch, file4FE276D0.sch, file4FE276F3.sch, file4FE27748.sch, file4FE27756.sch, file4FE6399C.sch]
2012-09-27 Updated part number for LinearTech switcher, and fpga bank connector
    [bonefpga.ods]
2012-09-27 Changed both fpga bank connections to go to Bank 0.
    [bonefpga.sch, file4FE2765D.sch, file4FE276D0.sch, file4FE276F3.sch, file4FE27748.sch, file4FE27756.sch, file4FE6399C.sch]
2012-10-06 More clean up
    [bonefpga.sch, file4FE2765D.sch, file4FE276D0.sch, file4FE276F3.sch, file4FE27748.sch, file4FE27756.sch, file4FE6399C.sch]
2012-10-22 Changed Power supplies from 2 dual rail Linear Tech's to 3 TI TPS6123x series. This reduces BOM cost significantly (~14$). Added 32MB of SDRAM to Bank_0, set up to use the Spartan 6's MCB.
    [bonefpga.brd, bonefpga.ods, bonefpga.sch, file4FE2765D.sch, file4FE276D0.sch, file4FE276F3.sch, file4FE27748.sch, file4FE27756.sch]
2012-10-31 Placed new switching regulators on board. Placed 32MB SDRAM on board. Changed fpga_GPIO headers to PTH ones.
    [bonefpga.brd, bonefpga.csv, bonefpga.ods, bonefpga.sch, file4FE2765D.sch, file4FE276D0.sch, file4FE276F3.sch, file4FE27748.sch]
2012-11-10 Finished redesign of board using 4 layers instead of 6.
    [$bonefpga.brd, $file4FE6399C.sch, bonefpga.brd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]
2012-11-11 A few more minor changes after looking at the gerber. BOM and Itemized BOM updated.
    [bonefpga-Back.gbl, bonefpga-Front.gtl, bonefpga-Inner2.gbr, bonefpga-Inner3.gbr, bonefpga-Mask_Back.gbs, bonefpga-Mask_Front.gts, bonefpga-SilkS_Back.gbo, bonefpga-SilkS_Front.gto]
2012-12-07 More clean up to make the board manufacturable
    [$bonefpga.brd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]
2012-12-07 more changes to make sure it can be built
    [bonefpga.brd]
2012-12-31 Last commit for beaglebone cape contest. Various clean ups and a bit of documentation was done.
    [bonefpga-Back.gbl, bonefpga-Front.gtl, bonefpga-Inner2.gbr, bonefpga-Inner3.gbr, bonefpga-Mask_Back.gbs, bonefpga-Mask_Front.gts, bonefpga-PCB_Edges.gbr, bonefpga-SilkS_Back.gbo]
